lromain23/rc2g/Documentation/Images/_DSC8989.JPG

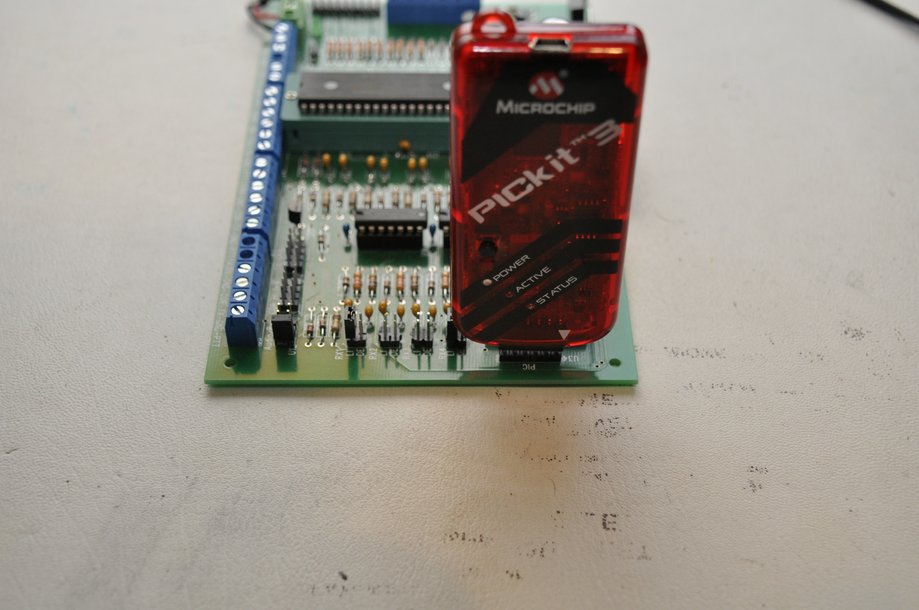
Documentation/Images/_DSC8989.JPG
