lromain23/rc2g/Documentation/Images/_DSC8988.JPG

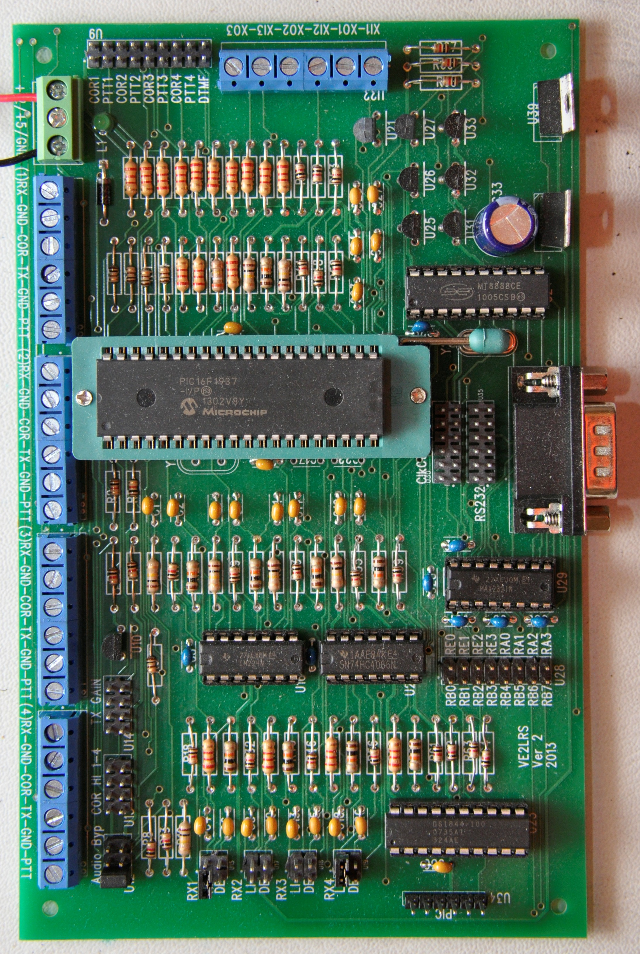
Documentation/Images/_DSC8988.JPG
