lromain23/rc2g/Documentation/Images/PinHeaders.pptx

U12 Pin Header
1 | From RX Audio | 2 | To Audio TX
3 | Aux Audio In | 4 | Audio to PIC
5 | +5V | 6 | VSS

## Slide 2

U30 Pin Header
1 | DTMF Clock Out | 2 | PIC Clock In
3 | PWM Out | 4 | PIC Clock Out
5 | I2C Data | 6 | I2C Clock
7 | PIC RD7 (Pin 30) | 8 | DTMF CS (Pull down)
9 | PIC MCLR/RE3 (Pin 1) | 10 | VSS
11 | +5V | 12 | +2.5V

## Slide 3

U35 Pin Header
1 | DCD | 2 | RTS
3 | DTR | 4 | CTS
5 | T2In (TTL) | 6 | T2Out (RS232)
7 | R2Out (TTL) | 8 | R2In (RS232)
