lromain23/rc2g/Documentation/Images/_DSC8990.JPG

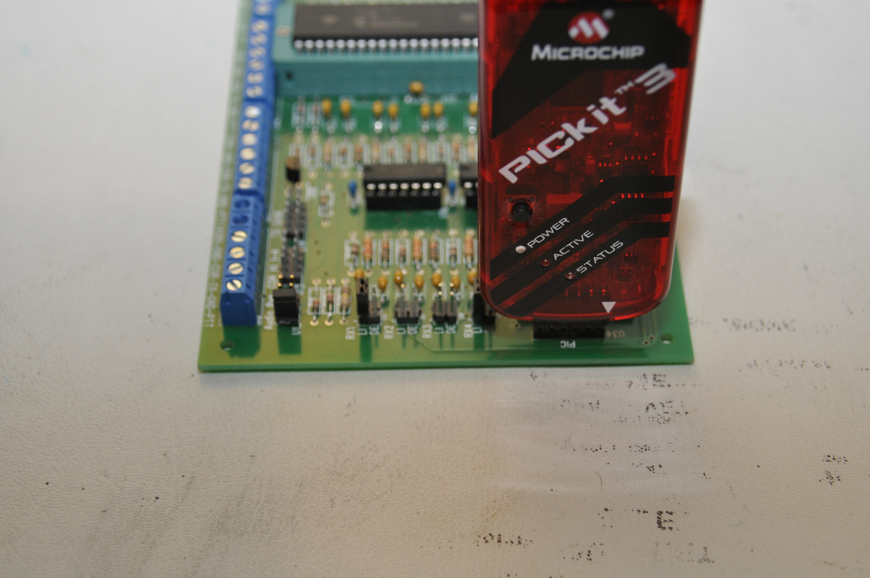
Documentation/Images/_DSC8990.JPG
