lromain23/rc2g/Documentation/Images/_DSC8992.JPG

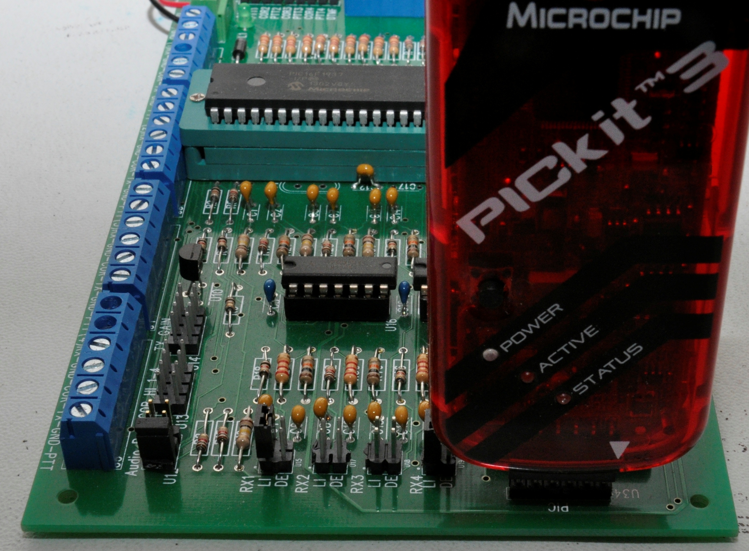
Documentation/Images/_DSC8992.JPG
