lromain23/rc2g/Documentation/Images/IMG_0647.JPG

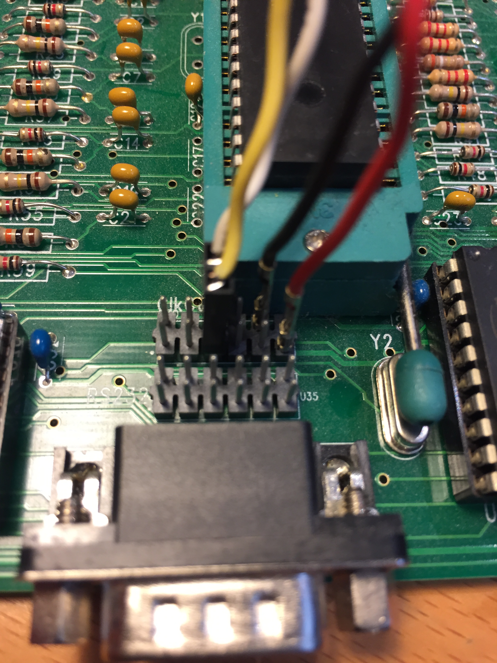
Documentation/Images/IMG_0647.JPG
