lromain23/rc2g/Documentation/Images/IMG_0648.JPG

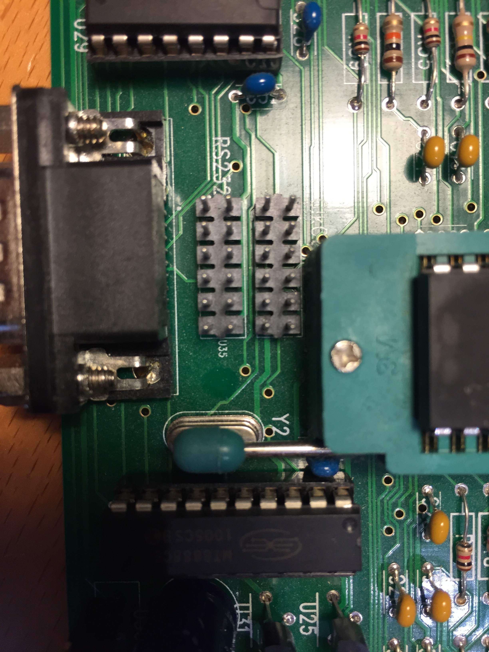
Documentation/Images/IMG_0648.JPG
