lromain23/rc2g/Documentation/Images/IMG_0649.JPG

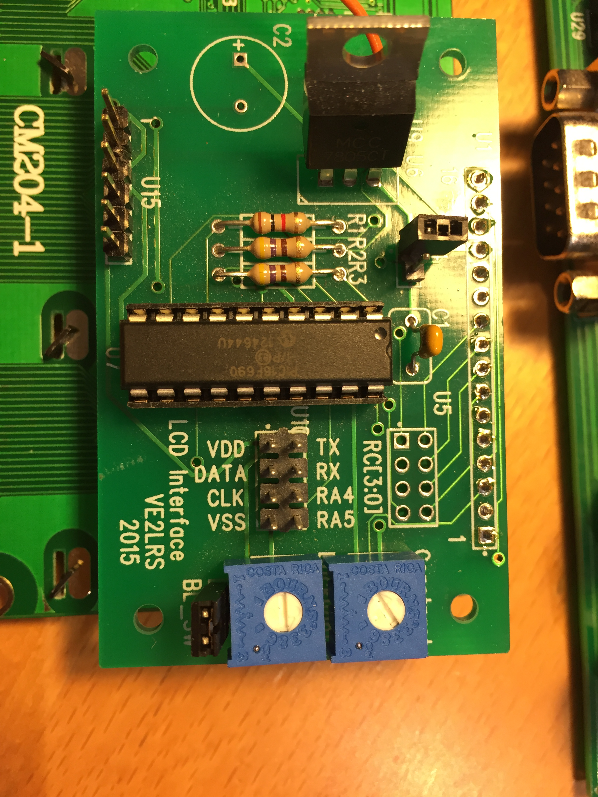
Documentation/Images/IMG_0649.JPG
