lromain23/rc2g/(commit log)

2013-04-20 Debugged COR_IN interrupt.
2013-04-21 Debugged i2c functions. The last i2c_read must always do a nak (no ack): argument 0.
2013-10-11 Debugged I2C using special LCD commands.
2013-10-11 Full support for 20x4 LCD display via I2C.
2014-02-18 Added support for AuxIn commands. Debugged compilation issues.
    [Firmware.c, Firmware.h, Site_XX.h]
2014-03-07 Implemented TOT timer (5 mins)
2015-02-05 Added restart_wdt() calls and clear DTMF interrupt; It did not clear correctly in simulator.
    [Firmware.c, Firmware.h]
2015-02-06 Fixed bug with display of register names.
    [Firmware.c, Firmware.h, Site_XX.h]
2016-06-05 Debugged 120V detection with Morse 'b' out.
2016-06-09 Added LCD display reset/clear commands.
    [Firmware.c, Firmware.h]
2019-03-12 Updated document with LCD i2c interface connections.
2020-04-29 Fixed COR pull-ups. Disabling the internal pull-ups when CORs are active high.
    [Firmware.c, Firmware.h, Site_XX.h]
